chillKB/ice60v1/README.txt

This is my first ever PCB design. It is tested and working, but I was still learning and it definitely does not follow best practices.

Check out my GitHub profile for more recent designs since I love making PCBs, especially 60% ones.
