chillKB/ice60v1/ice60.kicad_pcb

## KiCad design ice60.kicad_pcb (2023-01-08)

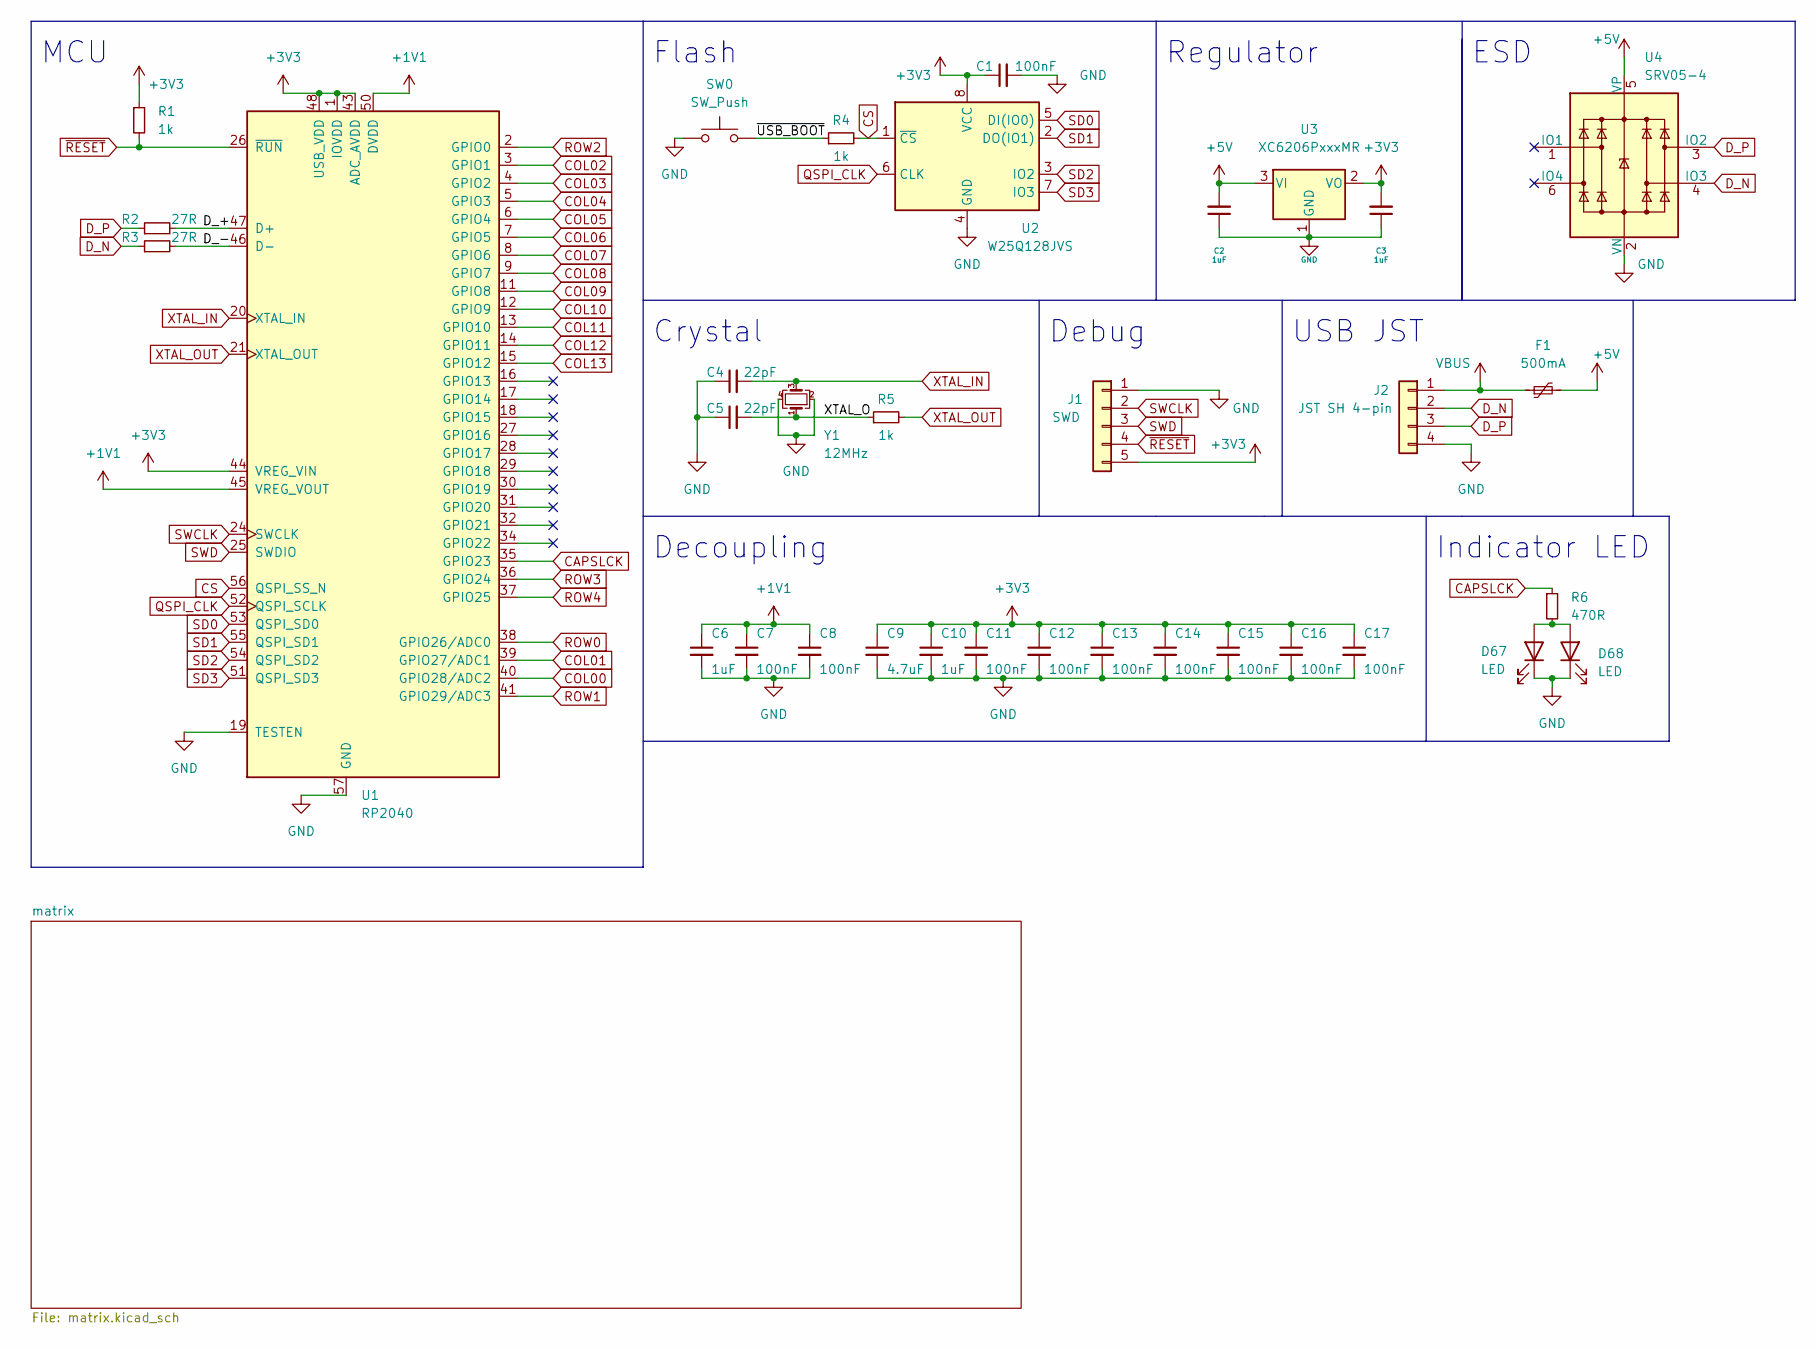
[picture p1: schematic ice60.kicad_sch]

Parts:
C1, C7, C8, C11, C12, C13, C14, C15, C16, C17: 100nF; C_0402_1005Metric; LCSC C1525
C2, C3, C6, C10: 1uF; C_0402_1005Metric; LCSC C52923
C4, C5: 22pF; C_0402_1005Metric; LCSC C1555
C9: 4.7uF; C_0402_1005Metric; LCSC C15525
D67: LED; LED_MX_3mm
D68: LED; LED_MX_3mm-FLIPPED
F1: 500mA; Fuse_1206_3216Metric; LCSC C135342
J1: SWD; PinSocket_1x05_P2.54mm_Vertical
J2: JST SH 4-pin; JST_SH_SM04B-SRSS-TB_1x04-1MP_P1.00mm_Horizontal; LCSC C160404
R1, R4, R5: 1k; R_0402_1005Metric; LCSC C11702
R2, R3: 27R; R_0603_1608Metric; LCSC C25190
R6: 470R; R_0402_1005Metric; LCSC C25117
SW0: SW_Push; PinSocket_1x02_P2.54mm_Vertical
U1: RP2040; RP2040-QFN-56; LCSC C2040
U2: W25Q128JVS; SOIC-8_5.23x5.23mm_P1.27mm; LCSC C131025
U3: XC6206PxxxMR; SOT-23; LCSC C5446
U4: SRV05-4; SOT-23-6-routable; LCSC C85364
Y1: 12MHz; Crystal_SMD_3225-4Pin_3.2x2.5mm; LCSC C9002

Connections:
+1V1: C6.1, C7.1, C8.1, U1.23 (DVDD), U1.45 (VREG_VOUT), U1.50 (DVDD)
+3V3: C1.1, C3.2, C9.1, C10.1, C11.1, C12.1, C13.1, C14.1, C15.1, C16.1, C17.1, J1.5, R1.1, U1.1 (IOVDD), U1.10 (IOVDD), U1.22 (IOVDD), U1.33 (IOVDD), U1.42 (IOVDD), U1.43 (ADC_AVDD), U1.44 (VREG_VIN), U1.48 (USB_VDD), U1.49 (IOVDD), U2.8 (VCC), U3.2 (VO)
+5V: C2.2, F1.2, U3.3 (VI), U4.5 (VP)
/D_+: R2.2, U1.47 (D+)
/D_-: R3.2, U1.46 (D-)
/XTAL_O: C5.2, R5.1, Y1.1
/~USB_BOOT: R4.1, SW0.2
CAPSLCK: R6.1, U1.35 (GPIO23)
COL00: U1.40 (GPIO28/ADC2); also elsewhere on the board
COL01: U1.39 (GPIO27/ADC1); also elsewhere on the board
COL02: U1.3 (GPIO1); also elsewhere on the board
COL03: U1.4 (GPIO2); also elsewhere on the board
COL04: U1.5 (GPIO3); also elsewhere on the board
COL05: U1.6 (GPIO4); also elsewhere on the board
COL06: U1.7 (GPIO5); also elsewhere on the board
COL07: U1.8 (GPIO6); also elsewhere on the board
COL08: U1.9 (GPIO7); also elsewhere on the board
COL09: U1.11 (GPIO8); also elsewhere on the board
COL10: U1.12 (GPIO9); also elsewhere on the board
COL11: U1.13 (GPIO10); also elsewhere on the board
COL12: U1.14 (GPIO11); also elsewhere on the board
COL13: U1.15 (GPIO12); also elsewhere on the board
CS: R4.2, U1.56 (QSPI_SS_N), U2.1 (~CS)
D_N: J2.2, R3.1, U4.4 (IO3)
D_P: J2.3, R2.1, U4.3 (IO2)
GND: C1.2, C2.1, C3.1, C4.1, C5.1, C6.2, C7.2, C8.2, C9.2, C10.2, C11.2, C12.2, C13.2, C14.2, C15.2, C16.2, C17.2, D67.1 (K), D68.1 (K), J1.1, J2.4, SW0.1, U1.19 (TESTEN), U1.57 (GND), U2.4 (GND), U3.1 (GND), U4.2 (VN), Y1.2, Y1.4
unnamed: D67.2 (A), D68.2 (A), R6.2
QSPI_CLK: U1.52 (QSPI_SCLK), U2.6 (CLK)
ROW0: U1.38 (GPIO26/ADC0); also elsewhere on the board
ROW1: U1.41 (GPIO29/ADC3); also elsewhere on the board
ROW2: U1.2 (GPIO0); also elsewhere on the board
ROW3: U1.36 (GPIO24); also elsewhere on the board
ROW4: U1.37 (GPIO25); also elsewhere on the board
SD0: U1.53 (QSPI_SD0), U2.5 (DI(IO0))
SD1: U1.55 (QSPI_SD1), U2.2 (DO(IO1))
SD2: U1.54 (QSPI_SD2), U2.3 (IO2)
SD3: U1.51 (QSPI_SD3), U2.7 (IO3)
SWCLK: J1.2, U1.24 (SWCLK)
SWD: J1.3, U1.25 (SWDIO)
VBUS: F1.1, J2.1
XTAL_IN: C4.2, U1.20 (XTAL_IN), Y1.3
XTAL_OUT: R5.2, U1.21 (XTAL_OUT)
~RESET: J1.4, R1.2, U1.26 (~RUN)

Notes on the sheet:
Crystal
Indicator LED
USB JST
Regulator
ESD
MCU
Debug
Flash
Decoupling

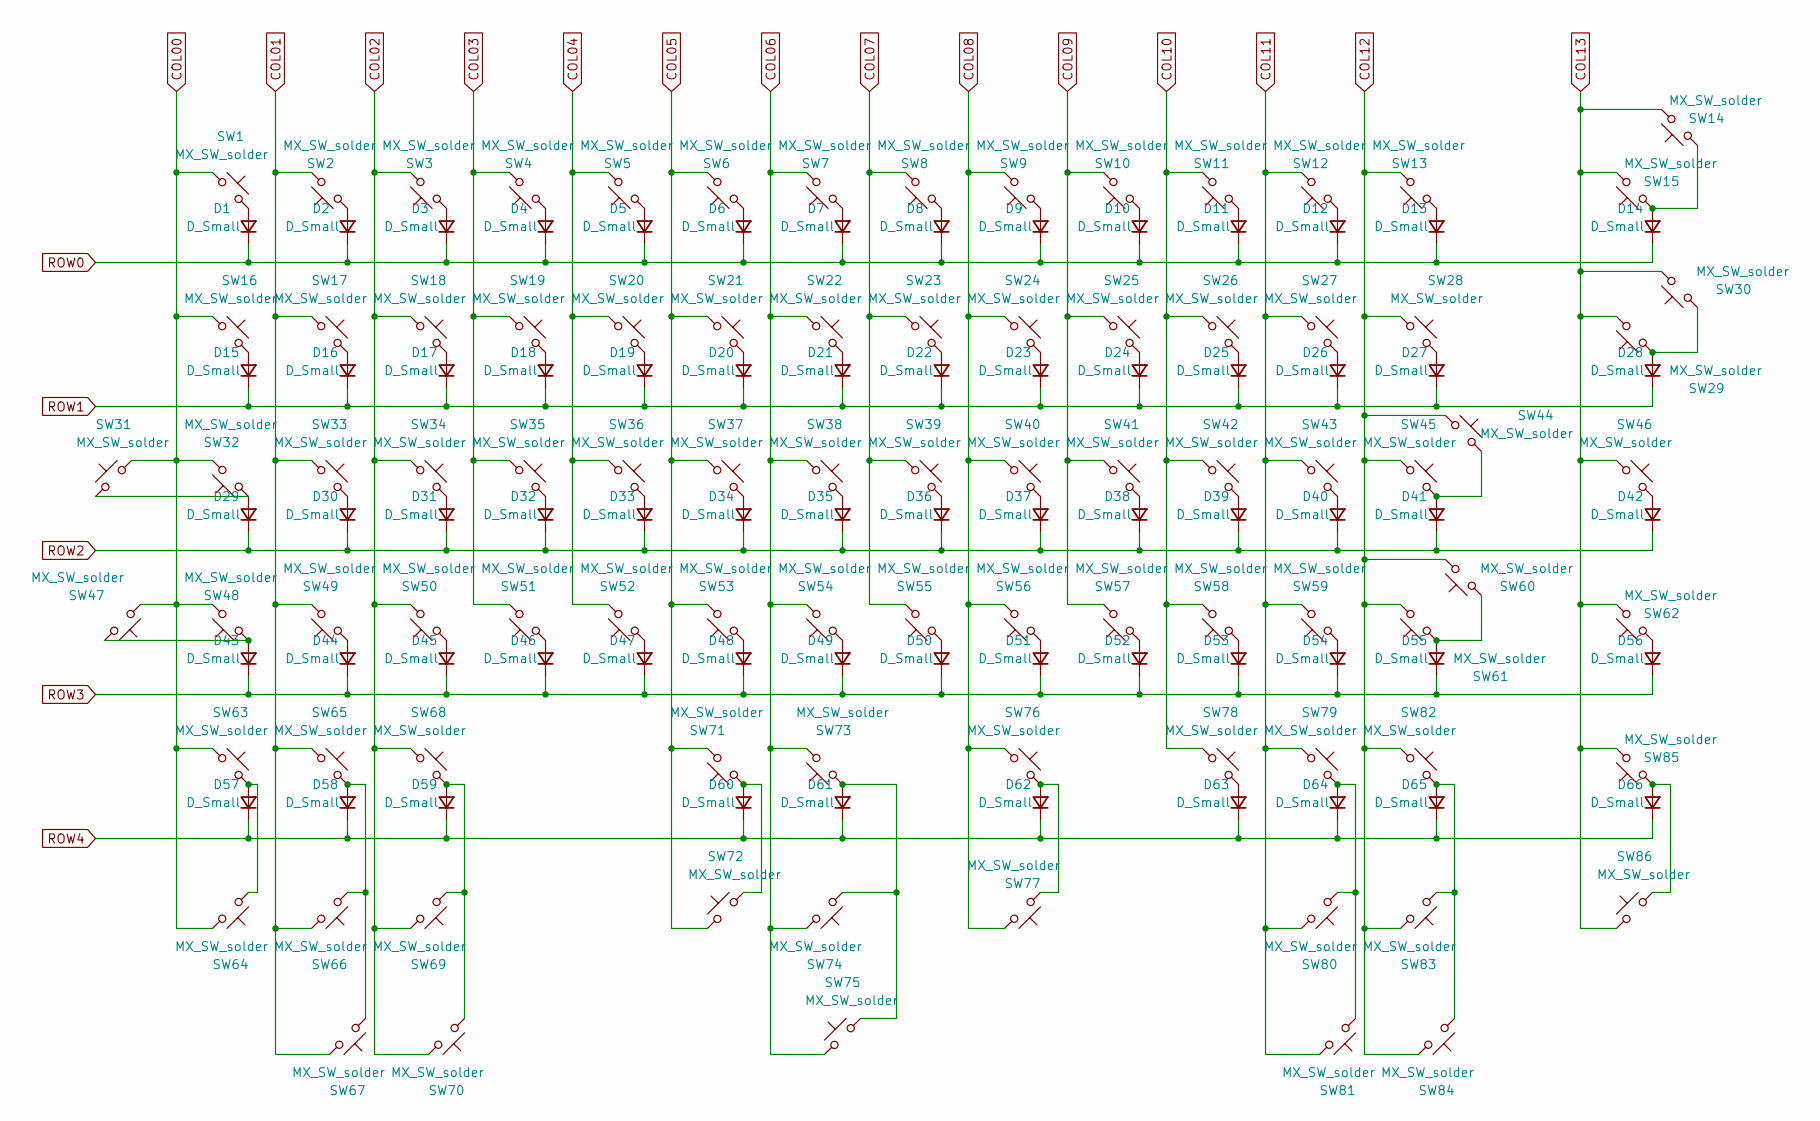
[picture p2: schematic matrix.kicad_sch, ice60]

Parts:
D1, D2, D3, D4, D5, D6, D7, D8, D9, D10, D11, D12, D13, D14, D15, D16, D17, D18, D19, D20, D21, D22, D23, D24, D25, D26, D27, D28, D29, D30, D31, D32, D33, D34, D35, D36, D37, D38, D39, D40, D41, D42, D43, D44, D45, D46, D47, D48, D49, D50, D51, D52, D53, D54, D55, D56, D57, D58, D59, D60, D61, D62, D63, D64, D65, D66: D_Small; D_SOD-123; LCSC C81598
SW1, SW2, SW3, SW4, SW5, SW6, SW7, SW8, SW9, SW10, SW11, SW12, SW13, SW14, SW15, SW17, SW18, SW19, SW20, SW21, SW22, SW23, SW24, SW25, SW26, SW27, SW28, SW30, SW33, SW34, SW35, SW36, SW37, SW38, SW39, SW40, SW41, SW42, SW43, SW44, SW45, SW46, SW48, SW49, SW50, SW51, SW52, SW53, SW54, SW55, SW56, SW57, SW58, SW59, SW61, SW62, SW66, SW71, SW72, SW73, SW75, SW76, SW77, SW83: MX_SW_solder; SW_MX_1u
SW16, SW29, SW64, SW69, SW80, SW86: MX_SW_solder; SW_MX_1.5u
SW31: MX_SW_solder; SW_MX_1.75u_stp
SW32, SW60: MX_SW_solder; SW_MX_1.75u
SW47, SW63, SW65, SW67, SW68, SW70, SW74, SW78, SW79, SW81, SW82, SW84, SW85: MX_SW_solder; SW_MX_1.25u

Connections:
COL00: SW1.1, SW16.1, SW31.1, SW32.2, SW47.2, SW48.2, SW63.1, SW64.1; also elsewhere on the board
COL01: SW2.2, SW17.1, SW33.1, SW49.2, SW65.1, SW66.1, SW67.1; also elsewhere on the board
COL02: SW3.2, SW18.1, SW34.1, SW50.2, SW68.1, SW69.1, SW70.1; also elsewhere on the board
COL03: SW4.2, SW19.1, SW35.1, SW51.2; also elsewhere on the board
COL04: SW5.2, SW20.1, SW36.1, SW52.2; also elsewhere on the board
COL05: SW6.2, SW21.1, SW37.1, SW53.2, SW71.2, SW72.2; also elsewhere on the board
COL06: SW7.2, SW22.1, SW38.1, SW54.2, SW73.2, SW74.1, SW75.2; also elsewhere on the board
COL07: SW8.2, SW23.1, SW39.1, SW55.2; also elsewhere on the board
COL08: SW9.2, SW24.1, SW40.1, SW56.2, SW76.1, SW77.1; also elsewhere on the board
COL09: SW10.2, SW25.1, SW41.1, SW57.2; also elsewhere on the board
COL10: SW11.2, SW26.1, SW42.1, SW58.2, SW78.1; also elsewhere on the board
COL11: SW12.2, SW27.1, SW43.1, SW59.2, SW79.1, SW80.1, SW81.1; also elsewhere on the board
COL12: SW13.2, SW28.1, SW44.1, SW45.1, SW60.2, SW61.2, SW82.1, SW83.1, SW84.1; also elsewhere on the board
COL13: SW14.2, SW15.2, SW29.2, SW30.2, SW46.1, SW62.2, SW85.2, SW86.2; also elsewhere on the board
unnamed: D1.2 (A), SW1.2
unnamed: D2.2 (A), SW2.1
unnamed: D3.2 (A), SW3.1
unnamed: D4.2 (A), SW4.1
unnamed: D5.2 (A), SW5.1
unnamed: D6.2 (A), SW6.1
unnamed: D7.2 (A), SW7.1
unnamed: D8.2 (A), SW8.1
unnamed: D9.2 (A), SW9.1
unnamed: D10.2 (A), SW10.1
unnamed: D11.2 (A), SW11.1
unnamed: D12.2 (A), SW12.1
unnamed: D13.2 (A), SW13.1
unnamed: D14.2 (A), SW14.1, SW15.1
unnamed: D15.2 (A), SW16.2
unnamed: D16.2 (A), SW17.2
unnamed: D17.2 (A), SW18.2
unnamed: D18.2 (A), SW19.2
unnamed: D19.2 (A), SW20.2
unnamed: D20.2 (A), SW21.2
unnamed: D21.2 (A), SW22.2
unnamed: D22.2 (A), SW23.2
unnamed: D23.2 (A), SW24.2
unnamed: D24.2 (A), SW25.2
unnamed: D25.2 (A), SW26.2
unnamed: D26.2 (A), SW27.2
unnamed: D27.2 (A), SW28.2
unnamed: D28.2 (A), SW29.1, SW30.1
unnamed: D29.2 (A), SW31.2, SW32.1
unnamed: D30.2 (A), SW33.2
unnamed: D31.2 (A), SW34.2
unnamed: D32.2 (A), SW35.2
unnamed: D33.2 (A), SW36.2
unnamed: D34.2 (A), SW37.2
unnamed: D35.2 (A), SW38.2
unnamed: D36.2 (A), SW39.2
unnamed: D37.2 (A), SW40.2
unnamed: D38.2 (A), SW41.2
unnamed: D39.2 (A), SW42.2
unnamed: D40.2 (A), SW43.2
unnamed: D41.2 (A), SW44.2, SW45.2
unnamed: D42.2 (A), SW46.2
unnamed: D43.2 (A), SW47.1, SW48.1
unnamed: D44.2 (A), SW49.1
unnamed: D45.2 (A), SW50.1
unnamed: D46.2 (A), SW51.1
unnamed: D47.2 (A), SW52.1
unnamed: D48.2 (A), SW53.1
unnamed: D49.2 (A), SW54.1
unnamed: D50.2 (A), SW55.1
unnamed: D51.2 (A), SW56.1
unnamed: D52.2 (A), SW57.1
unnamed: D53.2 (A), SW58.1
unnamed: D54.2 (A), SW59.1
unnamed: D55.2 (A), SW60.1, SW61.1
unnamed: D56.2 (A), SW62.1
unnamed: D57.2 (A), SW63.2, SW64.2
unnamed: D58.2 (A), SW65.2, SW66.2, SW67.2
unnamed: D59.2 (A), SW68.2, SW69.2, SW70.2
unnamed: D60.2 (A), SW71.1, SW72.1
unnamed: D61.2 (A), SW73.1, SW74.2, SW75.1
unnamed: D62.2 (A), SW76.2, SW77.2
unnamed: D63.2 (A), SW78.2
unnamed: D64.2 (A), SW79.2, SW80.2, SW81.2
unnamed: D65.2 (A), SW82.2, SW83.2, SW84.2
unnamed: D66.2 (A), SW85.1, SW86.1
ROW0: D1.1 (K), D2.1 (K), D3.1 (K), D4.1 (K), D5.1 (K), D6.1 (K), D7.1 (K), D8.1 (K), D9.1 (K), D10.1 (K), D11.1 (K), D12.1 (K), D13.1 (K), D14.1 (K); also elsewhere on the board
ROW1: D15.1 (K), D16.1 (K), D17.1 (K), D18.1 (K), D19.1 (K), D20.1 (K), D21.1 (K), D22.1 (K), D23.1 (K), D24.1 (K), D25.1 (K), D26.1 (K), D27.1 (K), D28.1 (K); also elsewhere on the board
ROW2: D29.1 (K), D30.1 (K), D31.1 (K), D32.1 (K), D33.1 (K), D34.1 (K), D35.1 (K), D36.1 (K), D37.1 (K), D38.1 (K), D39.1 (K), D40.1 (K), D41.1 (K), D42.1 (K); also elsewhere on the board
ROW3: D43.1 (K), D44.1 (K), D45.1 (K), D46.1 (K), D47.1 (K), D48.1 (K), D49.1 (K), D50.1 (K), D51.1 (K), D52.1 (K), D53.1 (K), D54.1 (K), D55.1 (K), D56.1 (K); also elsewhere on the board
ROW4: D57.1 (K), D58.1 (K), D59.1 (K), D60.1 (K), D61.1 (K), D62.1 (K), D63.1 (K), D64.1 (K), D65.1 (K), D66.1 (K); also elsewhere on the board

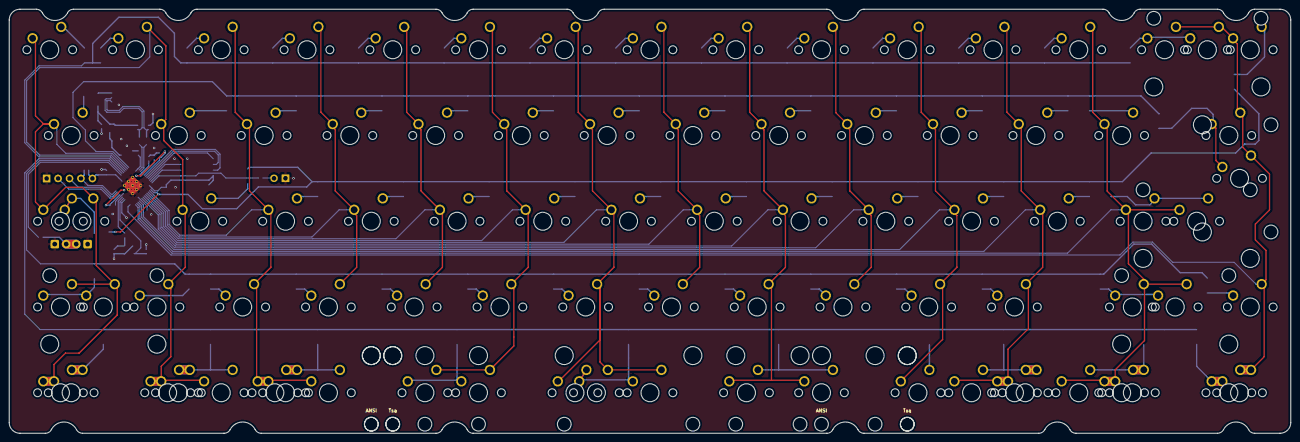
[picture p3: board ice60.kicad_pcb from above]

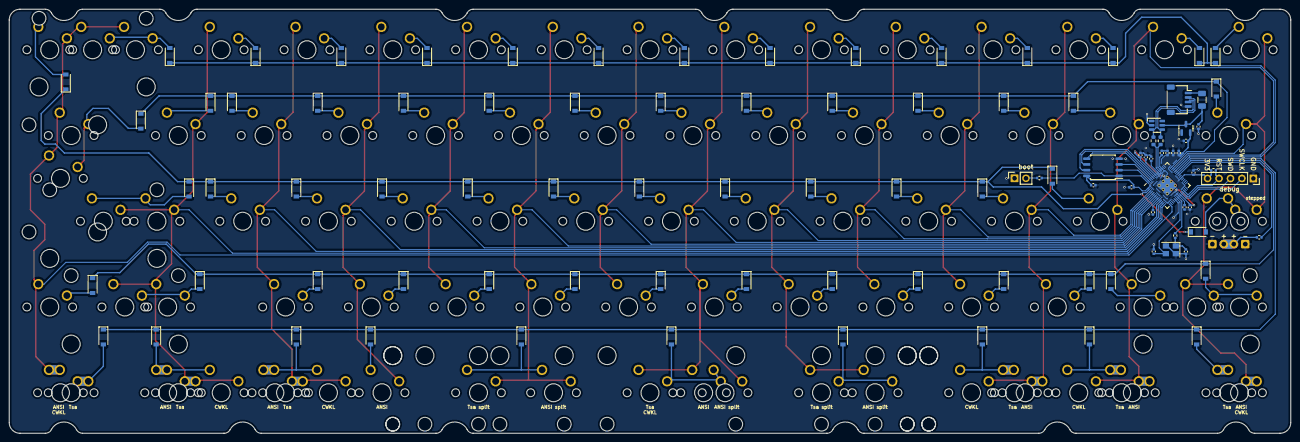
[picture p4: board ice60.kicad_pcb from below]

Board: 2 copper layers, 284.7 x 94.2 mm, 186 parts (98 on the bottom side), 109 nets.
