chillKB/ice60v1/(commit log)

2022-12-27 initial schematic w/o switch matrix
    [ice60.kicad_pcb, ice60.kicad_sch]
2022-12-27 update libraries
    [RP2040_QFN_PACKAGE.STEP]
2022-12-27 remove old copies of libraries
    [RP2040_QFN_PACKAGE.STEP]
2022-12-27 update files that slipped through library change
    [ice60.kicad_sch]
2022-12-27 rearrange schematic
    [ice60.kicad_sch]
2022-12-27 initial matrix schematic
    [ice60.kicad_sch, matrix.kicad_sch]
2022-12-28 clean up
    [ice60.kicad_sch, matrix.kicad_sch]
2022-12-28 place switch and stab footprints
    [ice60.kicad_pcb, ice60.kicad_sch, matrix.kicad_sch]
2022-12-28 flip some switches to simplify routing
    [ice60.kicad_pcb, matrix.kicad_sch]
2022-12-28 preliminary diode placement
    [ice60.kicad_pcb]
2022-12-28 tweak diodes
    [ice60.kicad_pcb, ice60.kicad_sch, matrix.kicad_sch]
2022-12-28 preliminary SMD component placements
    [ice60.kicad_pcb, ice60.kicad_sch, matrix.kicad_sch]
2022-12-29 improve footprint positions
    [ice60.kicad_pcb]
2022-12-29 wire up most things other than matrix
    [ice60.kicad_pcb, ice60.kicad_sch]
2022-12-29 route columns and row 0
    [ice60.kicad_pcb, ice60.kicad_sch]
2022-12-29 complete initial routing
    [ice60.kicad_pcb, ice60.kicad_sch]
2022-12-30 add ground fill and missing connections
    [ice60.kicad_pcb]
2022-12-30 improve row3 and row4 routing
    [ice60.kicad_pcb]
2022-12-30 o ring mounting cutouts
    [ice60.kicad_pcb, ice60.kicad_sch, matrix.kicad_sch]
2023-01-01 redo vcc routing under MCU
    [ice60.kicad_pcb]
2023-01-03 reroute USB data & several tweaks
    [ice60.kicad_pcb, ice60.kicad_sch]
2023-01-03 swap bulk cap & reroute debug
    [ice60.kicad_pcb, ice60.kicad_sch, matrix.kicad_sch]
2023-01-03 add capslock in-switch LED indicator
    [ice60.kicad_pcb, ice60.kicad_sch, matrix.kicad_sch]
2023-01-03 tweak JST placement
    [ice60.kicad_pcb]
2023-01-04 add some layout indicators to silkscreen
    [ice60.kicad_pcb]
2023-01-04 make JST placement less unique
    [ice60.kicad_pcb]
2023-01-04 reroute crystal
    [ice60.kicad_pcb]
2023-01-04 add part numbers for BOM
    [ice60.kicad_pcb, ice60.kicad_sch, matrix.kicad_sch]
2023-01-08 add rounded tracks version and logo
    [ice60.kicad_pcb]
2023-01-08 make one track a bit rounder
2023-01-08 another track too close to a hole
    [ice60.kicad_pcb]
2023-01-08 move some tracks slightly away from holes
    [ice60.kicad_pcb]
2023-01-09 add secondary JST footprint (bakeneko)
2023-01-10 exclude alternate JST from BOM and pos
2023-04-09 update to kicad 7, many small changes
    [ice60.kicad_sch, matrix.kicad_sch]
