chillKB/ice60v1/(notices)

Notices in the files:
ice60.kicad_sch:
© 2022 chillKB
CERN Open Hardware License version 2 -- Permissive
